shishberg/capybara/(commit log)

2026-08-23 Track the v3 pipeline; stop tracking node_modules
    v3/ has been untracked since it was started. It is now the whole PCB
    generator, so put it under version control: the BAML sources, the
    generated Kailh hotswap footprint library and the script that builds it,
    and the TypeScript harness that diffs placement against ergogen.
    node_modules/ was tracked, 3500 files of it, and churning on every npm
    install. package.json and package-lock.json are both committed, so
    `npm ci` reproduces it exactly.
    Also ignored: output_v3/ (one `make v3` away from the sources beside
    it), KiCad's per-user .kicad_prl and lock files, and v3/datasheets/,
    which is 63MB of vendor PDFs and a STEP model.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
2026-08-23 Stand the finger connectors on the pod-facing edge; fix the LED's rotation
    Both halves put their ribbon connectors on the edge facing the pod -- the
    right of the left half, the left of the right half -- so the cables leave
    toward the middle of the keyboard instead of doubling back around the
    board. Turning a connector through a right angle turns the fan-in with
    it, and three things had to follow.
    The connector's angle now decides the fan-in's planarity. Two chords
    joining two disjoint arcs of a convex region never cross exactly when
    the matching reverses the boundary order, and it is the connector's
    rotation that fixes which end contact 1 sits at. The angle that points
    the cable off the boa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
2026-08-24 v3: place ribbon connectors by where their cables go, shrink the key boards
    Every connector now points its cable at the board it feeds. The pod link
    stands on the inboard edge level with the switches and is met by a bus; the
    finger board's thumb link sits below the innermost column facing down; the
    thumb board's connector sits above its keys facing up.
    Turning a connector decides which end of it contact 1 is at, so the pinouts
    follow: rows reverse on both hands, columns only on the left. The bus turns
    its corner one row per conductor -- diagonals straight onto the lanes cross
    every lane. BUS_STANDOFF keeps the first lane clear of the connector's own
    mounting-peg ground pads.
    Finger boards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
2026-08-24 Separate the finger and thumb boards into a working flat layout
    The boards used to overlap where the thumb cluster tucks under the
    fingers, which cannot be fabricated as separate coplanar boards. Now:
    - Every key board escapes north; the fan band sits above the keys and
    the pod-link pinouts are re-derived for it (band_pinout).
    - The finger/thumb link pair sits in the inboard corridor above the
    thumb home key, both halves computing the same spot (link_spot) so
    the connectors face each other dead-on across a 3mm board gap.
    - The thumb fan runs on the back, tucked between the contact line and
    the near key's holes, surfacing through vias behind each contact.
    - Pass-throughs dive to the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
2026-08-24 v3: clear the LED variant's last DRC violations
    The chain now lands clean on all four key boards in both variants.
    * The thumb cluster gets its own hop shape and starts at the far key, so
    its head enters without crossing the cluster.
    * The finger head comes down the outside of the first column in the
    *column's* frame -- the columns are splayed, so a vertical drop walks
    across the key frame into the socket pads on one hand and the
    transition lanes on the other.
    * South of a key is one shared corridor: the LED's ground drop is now a
    stub straight off its pad instead of a hook across it, and the
    under-the-bottom crossing and the tail share the row it frees. The old
    deep crossing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
2026-08-24 v3: fix FFC cable mapping — every link was cross-wired end to end
    A same-side FFC between facing connectors joins contacts by position, and
    the facing turns one row around: pad 1 lands on pad N. Both ends of every
    ribbon assigned signal i to pad i, which no check could see — the combined
    view joins nets by name and nothing models the cable. The pod's two FFC
    connectors were also mounted with their cable openings toward the pod's
    centre, and the pod link's contact rows sat 4.5mm below the finger boards'.
    - from_end_signals: the from-end of each ribbon numbers its pads from the
    reversed signal list (pod for the pod links, finger for the thumb links)
    - pod_connector_angle flipped so the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
2026-08-24 v3: slope the fan band to the key stagger, and build LED-only
    The band above the finger keys was a flat slab held clear of the tallest
    column, wasting the whole ~25mm stagger over every other column. The exit
    line is now an ExitLine {y0, m}: finger_exit_line fits the tightest straight
    line that clears one constraint point per obstacle -- each column's top
    signal pad, each key's ground-stitch via (5.4mm higher than the pad; the
    flat design cleared these only by luck), and the LED chain's over-the-top
    column crossings, which climb to the taller neighbour's height. The whole
    band shears with the line, which preserves every planarity argument, and
    the flat clearance itself dropped from 13mm to w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
2026-08-25 v3: flatten the fan band and drop it onto the tallest column
    The sloped exit line was a mistake: it minimised slack over its constraint
    points, most of which sit on the short side columns, so it rode ~7mm high
    over the middle column -- the one place the eye (and the user) measures.
    Undo the slope entirely; the line is horizontal again and simply as low as
    the constraints allow.
    What actually lets it drop ~14mm:
    * LED column transitions no longer cross over the top of the columns. Both
    ends of a top transition attach on their east sides (west of every key,
    the key-below's socket ground hook climbs through the exit row), and the
    link threads the shared corridor and the eastern key's no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
2026-08-25 v3: stack the fan band per column so it hugs every column
    The flat exit line held all 16 band rows on one ladder fitted to the
    tallest column, so the six rows serving the inner and index columns --
    which turn off toward the connector before reaching the middle column --
    left ~8mm of empty air over the middle column's keycaps.
    Replace the shared line with per-column band groups: columns ordered
    nearest-the-connector-first, each group of rows sitting as low as that
    column's own top signal pads and ground-stitch vias allow, or one bus
    pitch above the previous group's top, whichever is farther out. Each
    column's escape channel now ends one bus gap short of its own group
    instead of on the shared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
2026-08-28 v3: emit the segmented outline, and fix what emitting it found
    The flex geometry existed and was tested but nothing wrote it out, so
    none of it had ever met KiCad. Emitting it turned up four real defects,
    each of which is now a test.
    Board gains `cuts: Vec2[][]` for interior Edge.Cuts contours, threaded
    through every construction site; `emit_panel` writes one closed polygon
    per cut, numbered from a range far clear of the outlines so a rigid
    board's file is unchanged by their existence. `flex_board.baml` turns a
    module into strips, cuts, parts and connectors, and `build_boards`
    dispatches to it on the new `flex` feature. `route.baml:enclose` never
    runs on that path -- on a segmented board th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
2026-08-28 v3: route the segmented finger boards for the matrix
    A second router. The direct-wired one in `route.baml` still builds the
    rigid boards, which are the shipping design and what every parity test
    pins; this one only ever sees a strip.
    The whole topology falls out of two facts about the Kailh footprint. Its
    drill holes shut out the middle of the strip on both layers, so the only
    lanes past a key are the two bands outside them -- and its socket pads
    own the west band on the back, so every run along a column is on the
    front. And everything the footprint owns lies north of the key centre,
    which leaves the strip below the bottom key clear across its full width:
    that is where the bus goes, and the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
2026-08-28 v3: place the pod connector from the fan the ribbon actually needs
    pod_lanes() guesses half the ribbon plus one, and the connector was placed
    from that guess. The guess holds for the twenty-way direct-wired ribbon; the
    eleven-way matrix ribbon puts every leg on the same side of the fan, so the
    channel ran two lanes past where the connector sat and both outer lanes
    crossed the FFC's mounting pegs -- four nets shorted to ground.
    Lay the fan out twice. The guess only feeds the connector's x and the split
    only depends on y, so a fan built against the guessed position already knows
    its true half-width.
    Claude-Session: https://cl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
2026-08-28 v3: drop probe.baml, a scratch dump that got swept into a commit
    Claude-Session: https://claude.ai/code/session_01ERBCadru14VoSwU2wTTzvK
2026-08-28 v3: flex routing rules, as checks
    Five rules a folded board has to obey, none of which DRC can see -- KiCad has
    no idea which parts of this outline fold. They run over the routed boards
    rather than over the functions that build them, so a future router still
    answers to them.
    The one that needed a change was the pour. `board_zones` pours over the whole
    outline, which on a segmented board means a solid plane across every ligament
    and down every neck: a stiffener where the board is meant to give, and a crack
    starter at the cut edge that starts it. Under the matrix neither switch
    terminal is ground, so the only ground on a finger board is the two links'
    contacts and mounting pegs -- and both li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
2026-08-28 v3: cut and route the thumb cluster
    The cluster is not the shape `strips_of` cuts. Its three keys sit almost
    in a plane, splayed round the thumb's arc rather than stacked along a
    cylinder, and the only place it wants to fold is the one gap wide enough
    to put a serpentine in. So it is cut the way BastardKB cuts its five-key
    cluster: rigid islands joined by one neck, {near, home} | {far}, which
    sends two lines over the seam where the other cut would send three.
    Everything is stated in the cluster's own frame -- x along the near-to-far
    run, y across it -- where the islands are rectangles and `Strip`,
    `flex_ring` and `strip_neck` apply unchanged. `Frame.flip` makes one
    description serve both ha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
2026-08-29 v3: move the pod connector off the tail, onto a shelf beside SW14
    The tail was 34mm of board hanging off the bottom of the inboard column,
    carrying both links. Below that column there is about 9mm of plan-view
    daylight before the thumb cluster's own keycaps start, so 25mm of that
    tail ran straight through the cluster it was reaching for.
    So the pod link comes off it. It stands instead on a shelf hung off the
    inboard edge beside the home key -- which is where the pod is, and the
    only stretch of that edge with a hinge row far enough away at both ends.
    The thumb link keeps the tail, pointing at the cluster below it, and the
    tail shrinks to the 11.6mm that one connector needs.
    The shelf is not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
2026-09-26 v4: track the chassis pipeline and editor
    v4 had been built up without ever being committed. Adds the v4 source,
    its make targets, the README pointer to the active design, and ignores
    for generated output, editor build artifacts and agent worktrees.
    [trackball.brd]
2026-09-26 v4: one hand-edited pod pin map, pod.json
    The pod's pins were spread across trackball.py (two maps of the same
    pins), validate.py, build_key_quotes.py, the v3 BAML header tables and a
    string-patched pinout.txt. pod.json now holds the module header, pin
    concession costs and the hand-chosen trackball and rgb groups.
    The seed stages its header and costs from pod.json and cannot take a
    fixed group's GPIO. The build reads the finished pod back into
    pod-pins.json, and renders pinout.txt and a full firmware-pinout.json
    from it. Validation and the RGB quote pod check against pod.json.
    All seven v4 boards are unchanged against a pre-refactor build. The RGB
    quote pod has the same footprints and nets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
    [pod_pins.py, seed.py]
2026-09-26 v4: docs match the key-tile decision; add design-status.md
    Record decisions and open questions in one place, mark the flex finger
    and flat thumb docs as paused reference, update LED power (module USB
    5V, ~300 mA cap), flag the Molex connector for replacement and the
    undersized chassis adapter placeholder.
2026-09-26 v4: power the LEDs from module USB 5V; swap to the JUSHUO FFC connector
    Drop the pod's separate J3 LED input and feed +5V from the module's 5V
    header pin, listed in pod.json's rgb group. Replace the Molex 200528-0240
    (MOQ 9,000) with the LCSC-stocked JUSHUO AFA07-S24FCA-00; the breakout
    grows to 36 x 33 mm. Both boards reroute DRC-clean and pass the audit.
    [draw_key_wiring_layout.py]
2026-09-26 v4: drop the 470 uF bulk capacitor from the hand breakout
    It came from the separate LED supply design; on USB power it only adds
    plug-in inrush. LED decoupling stays an open per-column question.
2026-09-26 v4: first prototype uses a perfboard pod and generic FFC adapters
    Custom PCBs have the longest turnaround and can't change once ordered,
    while the pod wiring will still change. The generated breakout and pod
    stay for a later build.
2026-09-26 v4: use 0.5 mm pitch FFC for the prototype ribbon
    Half the width of 1.0 mm cable, leaving more room to adjust the angle
    between the hands and the pod; the LED current is well within rating.
2026-09-27 v4: PROTOTYPE chassis shape options and extra thumb keys (throwaway)
    Six shapes on the same key poses (current shell, Skeletyl-style webbed
    well, column ribs, faceted block, pedestals, floating plate on legs) and
    three thumb options (3 keys, +2 outer, +2 tucked below). Open
    /prototype-shapes.html on the editor dev server.
2026-09-28 v4: PROTOTYPE Skeletyl construction, middle-ground shapes, moved extra thumbs
    Skeletyl construction rebuilt on Rosebear key poses; the old webbed well
    renamed Dactyl-Manuform. Adds soft-edged webbed well, machined tray and
    pebble facets; drops pedestals. Outer extra thumbs use finger splay;
    tucked-below extras sit under the gaps between the three thumb keys.
2026-09-28 v4: PROTOTYPE fix Skeletyl artefacts, rounded column ends, inner support, plate toggle
    Drop the smoothing that spiked thin walls, restore switch holes, one flat
    skirt per key, larger thumb window, quarter-round column ends inside an
    extended tray, solid inner wall joined to the thumbs, Cirque moved 8 mm
    out. Bottom plate checkbox; cam/caps/plate URL params for inspection.
2026-09-28 v4: PROTOTYPE skeletyl framed inner wall, column-end feet, one-piece check
    Column ends get a foot out to the tray rim so the case holds together
    without the removable base. The stats line reports how many pieces are
    left above the base; that check also found ribs plates only touching
    their ribs, now overlapped.
2026-09-28 v4: PROTOTYPE skeletyl floor ledge instead of feet, fix tray outline hull
    The feet reached toward the rim and were trimmed into fins. A 2 mm floor
    ledge now runs from the rim in under the column walls. The tray outline
    built its convex hulls with new CrossSection(points).hull(), whose fill
    rule dropped points, so back caps hung past the rim; it now uses a plain
    2D hull. The stats line also lists loose pieces and parts outside the rim
    by location, and ?only= / ?nocut=1 isolate Skeletyl parts for debugging.
2026-09-28 v4: PROTOTYPE eight-view review sheet script for chassis shapes
2026-09-28 v4: PROTOTYPE skeletyl bridged columns and angled end walls with a hugging tray
2026-09-28 v4: PROTOTYPE highlight skeletyl bridges in orange (?hl= tags, ?hlinfo=1 sizes)
2026-09-28 v4: PROTOTYPE skeletyl bridged variants join column end walls in their lower half
    Replaces the bars between the key-frame flanges. No rim or lip; the base
    plate is flush with the walls.
2026-09-28 v4: prototype three continuous column-end shapes (fitted, swept, carved); highlight off by default
2026-09-28 v4: prototype swept thumb-row front (skel-swept-thumbs)
2026-09-28 v4: prototype thumb layout with wells, wider spacing and room from the finger columns; keycap clearance check
2026-09-28 v4: promote the swept Skeletyl chassis to the editor, edited through key layout parameters
    Finger columns take three key heights, stagger, X offset, sideways tilt and
    splay; thumb clusters take centre, angle, tilts, arc radius, key spacing and
    well. Handles drag key heights, stagger, cluster centres and cluster angle.
    The chassis is generated from the key poses and checked for seats, openings,
    tile and keycap clearance, loose pieces and keycap gaps. The Cirque pod
    replaces the trackball placeholder.
2026-09-28 v4: side walls rise from the outside columns' plate edges and close the swept ends' corners
2026-09-28 v4: per-key walls that follow the plates past the tile pockets, U slots, base ribs and a connected-footprint check
    Walls on the inner and pinky columns and the thumb rows start at the plate edge
    just outside the tile pocket, follow the plate's tilt to the pocket's depth,
    then drop to the base, one segment per key with U slots between. Caps close the
    swept ends' quarter rounds. Ribs join the thumb rows and fingers along the base,
    and the checker requires one connected footprint without the bottom plate. The
    seat footprint shrinks to 15.8 mm and the cut above each plate only clears the
    housing rim and keycap travel. The bottom plate is hidden by default.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
2026-09-29 v4: plates sized from the switch seat, and nothing built into a tile pocket
    Plates are now 0.9 mm past the 15.8 mm seat (17.6 mm square) instead of keycap
    sized, so they no longer stick out past the swept ends; skirts, which the tile
    pockets would remove, are gone. Swept ends start past the end keys' tile
    pockets. Wall segments, joints and caps are built as separate tilted and
    vertical hulls so no hull reaches into a pocket on a rolled key. The thumb
    support and web are removed, the pod bracket is fixed to the plate corners,
    and the default thumb clusters move 3 mm toward the user to clear the fingers'
    front end. The checker fails when any part reaches into a tile pocket.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
2026-09-29 v4: restore the U slots between wall segments, which the smaller plates had disabled
2026-09-29 v4: descriptive names and typed wall strips, caps and curves in the chassis code (no geometry change)
2026-09-29 v4: named construction sizes and check limits, and a geometry fingerprint for refactors (no geometry change)
2026-09-29 v4: wall check for gaps and blind slots, and close the gaps and groove where the pinky wall meets its caps
    The checker looks straight through each wall segment and each U slot, taking in
    only the wall's own thickness. A hole that is not a slot is a gap; a slot with no
    hole is blind. Both are listed and highlighted. The chassis reports the windows.
    The cap's drop hull now shares the carried tilted part's bottom edge, which
    closes the wedge-shaped slits beside both pinky caps. The cap's round hull takes
    in the drop's outer top corner, which removes a shallow groove on rolled keys.
2026-09-29 v4: swept ends follow each column's end, and a check for chassis built where a keycap goes
    The swept end's curve was a quadratic fit through all the column ends, pushed
    out until the round started past every tile pocket in plan. That left 5-10 mm
    of flat plate at most column ends, and the front round reached far enough
    forward that the 1.5u thumb key's room cut 74 mm³ out of the inner column.
    Now the curve runs parallel to each column's plate edge, as close in as the
    tile pocket and switch body allow (they must stay inside the round's hollow,
    not just short of it in plan), and never inside the switch seat. A smooth
    maximum joins the columns' lines. Flats are now 0.4-2.3 mm.
    New check: the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
2026-09-29 v4: plates cover the tile, swept ends stay within the end plates, both thumb row ends tie to the fingers
2026-09-29 v4: walls flush with the plate edges, with a cutout under each key and posts between keys
2026-09-29 v4: experimental hex strut pattern for tall walls (chassis.wall_pattern)
2026-09-29 v4: cut the hex pattern off at the base strip on short walls
    Keys whose upright would be shorter than the wall width lose the strut
    below them, so the pinky column and extra thumb pair get the pattern too.
    End half hexagons are cut only where a cap closes the run's end. The wall
    check closes zero-width slits left by projection.
2026-09-29 v4: the wall check accepts holes a neighbouring key's opening passes through
2026-09-29 v4: default thumb clusters closer to the fingers and each other
2026-09-29 v4: fill the switch seats before trimming them
    Trimming first put the trimmed faces exactly on the seat plates' faces,
    and Manifold's union then dropped 18 mm³ elsewhere: a wedge cut from the
    index home plate's edge. Test the plate side edges against the chassis.
2026-09-29 v4: PROTOTYPE tile rests: webs between keys with feet under the tiles' edges
2026-09-30 v4: PROTOTYPE tile rests bridge the finger columns under the tiles' side edges
    In each finger row a rest joins neighbouring columns' plates; the outer
    columns get a bar across the wall cutout, hung from the plate either side.
    The thumb rows keep the rests along the row. The rests' cut starts at the
    plate's underside so they overlap the plate instead of sharing its edge face.
2026-09-30 v4: PROTOTYPE finger tile rests: short feet under the back of each tile's side edges
    A tile goes up 4.3 mm in front of its place and slides back onto the feet,
    which sit under the socket. The bridges between columns stay 12 mm long.
    Only the index, middle and ring columns' top and home tiles fit this way:
    bottom-row tiles hit the front swept end and outer-column tiles the wall
    posts.
2026-09-30 v4: PROTOTYPE finger tile rests every tile can be fitted past
    Feet and webs line up along the back of each tile's side edges, under the
    socket, from 2.3 mm behind the centre: a tile goes up 7.5 mm in front of its
    place and slides back. The bottom row is turned 180 degrees so its tiles
    slide forward, clear of the front swept end. The outer columns' tiles come in
    sideways through their wall cutouts, with feet at the cutouts' ends; the
    inner bottom tile, blocked by the trackpad pod, slides through a slot cut in
    the post. The wall check closes its view's ends so the slot's merged opening
    is still a hole, and a new test sweeps every finger tile's way in.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
2026-09-30 v4: walls stand outside the plate edges; catch small loose pieces
    The inner bottom post slot cut one of its tile's feet loose, and the
    loose-piece check missed it because it ignored pieces under 50 mm³. It
    now ignores only slivers under 0.5 mm³.
    Walls now stand wall_mm outside the plate edges, so the tile pockets stay
    inside them rather than running out through the wall. Every finger tile
    now slides onto its feet, including the outer columns', so tile_side_entry
    and the post slot are gone; the outer feet hang from the wall. Swept ends
    run on to the wall's face, the hex openings stop at the plate's
    underside, and the pod bracket reaches the wall's face.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
2026-10-01 v4: model the hand wiring, adapter mount, ribbon and trackpad housing in the editor
    Provisional, from photos and spec sheets: tile pads, a 4 x 5 matrix per
    hand (thumbs as row RX on ribbon pin 12), wires routed pad to pad and to a
    generic 24-way FFC adapter on the bottom plate, with a ribbon landing and
    notch in the inner wall. Thumb wires reach the fingers through a round port.
    The trackpad housing is a separate, symmetric print on a dovetail mount.
    New checks: wires, solder access, housing fit and slide. Old projects are
    migrated to the new config sections.
2026-10-01 v4: document the wiring model, the 4 x 5 matrix and the new chassis parts
2026-10-01 v4: route wires without crossings, close under the tiles, in the build worker; adapter toggle
    Legs hop 0.6 mm under the tile and run strips from 2.7 mm. Port wires
    take their own places on a 1.02 mm hex grid in the 5 mm port. A
    negotiated router with blocker pushing, group repair and a wide second
    pass removes all crossings, and the fit report now checks wire against
    wire. Routing moves into the build worker, so wires update on rebuild.
    A new "Adapter and ribbons" toggle hides the adapter.
2026-10-01 v4: keep the bottom row facing the same way as the others
    The bottom row was turned 180 degrees so its tiles could slide forward onto
    their rests. Instead it keeps its orientation, and its tiles slide forward
    onto feet under the front of their side edges; the router keeps wires out of
    that room. Finer shifts along a tile's edge and more blockers moved aside
    keep every fingerprint variant routing without crossings.
2026-10-01 v4: socket posts on the bottom plate hold the bottom row's socket end
    A bottom-row tile slides forward onto feet under the front of its side
    edges, so nothing held its socket end, and pressing a switch in would lever
    it down. A 3 mm post on the bottom plate now stands under the middle of each
    bottom-row socket, 0.3 mm below it. The router keeps wires off the posts as
    round obstacles, and its restarts shuffle the order of the wires that already
    met nothing, so every fingerprint variant still routes without crossings.
2026-10-01 Revert "v4: socket posts on the bottom plate hold the bottom row's socket end"
    This reverts commit 96f0486c5f78318bc8677b8d491f79ba2b8adf66.
2026-10-01 v4: hold a bottom-row tile up by hand while its switch is pressed in
2026-10-01 v4: lids over the finger tiles' feet hold each tile edge in a slot
    The bottom row's feet are under the front of the tile, so pressing a switch
    in levered the socket end down about them. A lid from the plate to 0.2 mm
    above each foot stops the tile tipping. The seat test now skips edge rays
    that start inside both bodies, where the plate runs on into a bridge.
2026-10-01 v4: bottom-row lids beyond the feet, not over them, so no support fills a slot
    The lids over the feet left a 1.8 mm slot that a print on its base would fill
    with support. The bottom row's lids now run from 6.5 mm in front of the centre
    to the tile's front end, and its feet stop 1.5 mm short of them, so nothing is
    under a lid down to the bed. The other rows' feet are under the socket and
    need no lids.
2026-10-10 v4: PROTOTYPE Commodore 64 breadbin chassis shape (c64 variant)
    Rectangular wedge with its deck tilted to a plane fitted through the key
    plates, bullnose front, rounded underside, rear chamfer with grill grooves,
    parting line, and the keys in a stepped well with a moat; the trackpad gets
    its own well like the C64's function keys. Beige shell, brown caps.
2026-10-10 v4: PROTOTYPE C64 breadbins, one per cluster (c64-clusters variant)
    The C64 builder now takes a list of bins, each built in its own plan
    rotation with its own deck plane, margins and bullnose. c64-clusters gives
    the fingers, the thumb row and the trackpad a tight bin each: 181 cm² in
    plan against 143 for skel-swept-thumbs and 311 for the single breadbin.
2026-10-10 v4: PROTOTYPE C64 bins drop the trackpad; moat is a thin trough following the case outline
2026-10-10 v4: PROTOTYPE C64 bins: thumb grill on the outer end, rounded top end edges, bottom section below the parting line
2026-10-10 v4: PROTOTYPE C64 bins follow the C64's side profile and are hollow
    Spline bullnose from a vertical front face into a deck that rises to the
    back at 5 degrees at least, a raked back face with a rounded top corner and
    the grill in front of it, ends rounded all round by lofting shrinking
    slices. 2 mm walls; the key wells keep their wall and floor, and each key
    stands on a hollow pedestal open to the case below. Trackpad support dropped.
2026-10-10 v4: PROTOTYPE C64 bins use the profile fitted to the C64 photo
    Fillets keep the photo's sizes and shapes, scaled so its gutter sits on
    the parting line; the grill top stays flat and the back stays two faces
    (7.2 degrees raked, then vertical) meeting at the gutter. The deck angle
    and the bin's depth and height come from the keys.
2026-10-10 v4: PROTOTYPE C64 bins keep the well floor above the parting line
    The bottom section is now a plain tray; where the deck is low the well
    floor sits just above the parting line instead of dropping into it.
    ?top=0 in the prototype hides the top case to show the bottom section.
2026-10-10 v4: PROTOTYPE C64 curved-deck variant; thumb bins lose their grill
    c64-curved fits a quadratic surface through each cluster's key plates and
    moves only the deck onto it: in front of the well it eases back onto the
    fitted bullnose, behind it ramps to a raised flat deck so the grill top
    stays flat. The thumb bins in both cluster variants have no grill.
2026-10-10 v4: PROTOTYPE C64 curved deck lofted from continuous sections, with four back treatments
    Each section across a curved bin is one outline (bullnose, key surface,
    ramp, flat top, back), lofted into a mesh. Variants: level top, top
    following the dish, deeper back, mid-height top. Also: thumb bin trimmed
    at the finger bin, finer end rounding, split at the parting groove's
    bottom, ?look= camera target.
2026-10-10 v4: PROTOTYPE C64 curved deck: drop the deeper-back variant, add a tilted straight top
2026-10-11 v4: PROTOTYPE shapes page: fresh manifold instance per build, coarser curved-deck loft
    Manifold objects were never freed, so a few curved builds exhausted wasm
    memory and every later switch failed (decompose: index out of bounds).
    The curved loft now uses fewer stations and section points (4.2 s to 1.8 s).
2026-10-11 v4: PROTOTYPE C64 curved deck holds level past the outer rows' key centres, lowering the front lip and back top
2026-10-11 v4: PROTOTYPE C64 curved deck: front lip and back top at the same height
2026-10-11 v4: PROTOTYPE shapes page: description and stats as HTML comments, not over the model
2026-10-11 v4: PROTOTYPE C64 curved deck holds level beyond the end columns' key centres, flattening the index end
2026-10-11 v4: PROTOTYPE C64 bins: port panel on the index end where the ribbon leaves
2026-10-11 v4: PROTOTYPE C64 bins: halve the end rounding to 2 mm; expose plan outlines as __plan
2026-10-11 v4: PROTOTYPE C64 joined variant: thumb row carried in the finger bin's deck sections, hard-cornered joint
    The finger bin's sections run forward over the thumb row to the thumb bin's
    front edge; the thumb surface meets the finger surface along a straight run
    between the wells' hulls, with a hard angle at each end. The loft now matches
    marked corners between sections so those angles don't twist.
2026-10-11 v4: PROTOTYPE C64 joined: thumb deck rises to the finger well rim at the pinky end; clean parting groove (cut without coincident faces)
2026-10-11 v4: PROTOTYPE C64 curved bins: flat top long enough for three grill grooves
2026-10-11 v4: PROTOTYPE C64 joined: one lofted solid, thumb sections turning to meet the finger bin's, index end rounded
2026-10-11 v4: PROTOTYPE shapes viewer: paint marks on the model (M), saved with camera, note and screenshot to prototype-marks/ via a dev-server endpoint
2026-10-11 v4: PROTOTYPE C64 joined: index end rounded with one outline shrunk unevenly (no merged thumb outline), pinky end rounds fully; smooth deck clamps (no crease); trench and grill cut without coincident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
    Also saves the first five painted marks, and ?marks=0 hides saved marks.
2026-10-11 v4: PROTOTYPE shapes viewer: Delete all saved marks button
2026-10-11 v4: PROTOTYPE C64 joined: optional C64 badge on a bin's grill (pill recess interrupting the grooves, five raised staggered stripes); new c64-joined-badge variant
2026-10-11 v4: PROTOTYPE C64 badge: stripes square-ended and lined up, not slanted
2026-10-11 v4: PROTOTYPE marks: inside-corner bottom edge
2026-10-11 v4: PROTOTYPE C64 badge: stripes run out to the centres of the pill's rounded ends
2026-10-11 v4: PROTOTYPE C64 joined: rounded wall between the thumb deck and the finger top instead of the ramp; trench stops either side of it; index end rounds in fully and stops against the thumb part (no sp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
2026-10-11 v4: PROTOTYPE C64 joined: wall between the decks 2.4 mm further forward; the thumb trench runs into it and stops flush
2026-10-11 v4: PROTOTYPE shapes: keep only the C64 joined chassis with the badge; drop the other 22 variants and the code only they used (Skeletyl, carved, machined, faceted, trackpad well, flat deck, other bac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
    The removed shapes stay in git history (b1cb2d8 has them all). The remaining build is pixel-identical to before.
2026-10-11 v4: PROTOTYPE C64 joined: finger trench runs on over the wall's rounded top edge and falls off it; the wall's round is in the mesh (loft runs sized by their longest section, round ends marked, 1 mm s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
2026-10-11 v4: PROTOTYPE C64 joined: the finger well's front edge carries straight on past its ends, so the wall's top and strip don't step forward where the well ends (with the mark)
2026-10-11 v4: C64 case is the editor's chassis: plate sheets per well, rooms and skirts, tiles glued to pads; no trackpad, ribbon out the port panel
    - shell.ts (from the prototype's variants.ts) builds the C64 case; chassis.ts puts
    the plates in its wells as one sheet per well, with 2 mm reaches and joins,
    rooms cut under the plates and skirts closing the deck's wall
    - tile rests, bridges, feet, walls and the trackpad housing are gone; tiles are
    glued to four L pads under each plate
    - wiring: plates are obstacles; joins step back under the higher tile, turn a
    corner or run under both ends
    - extra thumbs moved 1.5 mm out and 1.5 mm forward to clear the finger well
    - buildSolid frees every Manif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
2026-10-11 v4: rebuild in about 3 s instead of 11.5 s, with the same wiring and checks
    - Route the wires once per build, not once for the skirts and again for the checks.
    - Wire router (2.8 s to 1.1 s, same routes): legs and the joins between them are
    made once and shared; segment tests use a plan grid of the obstacles and skip
    any obstacle whose gap on one axis is past the wire's reach; caches key on
    shared points, not strings.
    - Checks test against each key's piece of the chassis (cut from its column's,
    cut from the whole once), not the whole chassis, for every probe and envelope.
    - Keycap rooms and switch holes are cut in one boolean, not two per key.
    - Skirt notches only from the wire segme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
2026-10-11 v4: route the wires in their own worker while the shell is lofted; climbs found once per leg (rebuild about 2.2 s in the browser)
2026-10-11 v4: the port insert holds the ribbon: a neck through the wall and the tie-down landing inside, placed from the panel instead of the adapter (which stands 4 mm further in)
2026-10-11 v4: loft the wall between the decks every millimetre where it fades out, so it no longer twists into a fan of slivers
2026-10-11 v4: PROTOTYPE ?plates=narrow: finger plates flat only 0.8 mm past the switch seat, falling at 60 degrees (?slope=) by up to 2 mm towards the well's wall, joins between in-line neighbours cut the same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
2026-10-11 v4: PROTOTYPE ?plates=narrow: lower the finger sheet's top 2 mm along the well's wall outside each key's keep (flat to 0.8 mm past the seat, then 60 degrees down) and its neighbours' bridged keeps, r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
2026-10-11 v4: PROTOTYPE ?plates=narrow: build each finger plate narrow instead of cutting full plates down: full thickness only to 0.8 mm past the seat on sides facing the wall, then a 60 degree slope down 2 m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
2026-10-11 v4: PROTOTYPE ?recess=mm: the case top this far above the plates' tops (default 3), the wells' walls reaching down as much further; key wells' corners square like the C64's
2026-10-11 v4: PROTOTYPE ?plates=facets: the finger plates as one 3 mm floor, each key's plate-top plane carried on until it meets its neighbours', out to the well's wall, flat to 0.8 mm past every seat; tiles 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
2026-10-11 v4: PROTOTYPE ?plates=facets: the room under the keys stops at the floor's underside, so it no longer cuts the well's wall away above the floor (the slot whose kinked edge looked jagged); the flat-ar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
2026-10-11 v4: editor: a remembered 'show edges' no longer crashes the page on load, before the first chassis has arrived
2026-10-11 v4: editor: the edges toggle is labelled Show wireframe
2026-10-11 v4: PROTOTYPE ?plates=facets: where a neighbour's plane stands above a key's flat area (the ring and pinky columns), a sloping step between the two flat areas' edges replaces the notches
2026-10-11 v4: PROTOTYPE ?plates=facets: the floor is a flat square 0.8 mm past each seat, straight strips between neighbours and a patch where four keys meet, carried on level past the outer keys to the wall, 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
2026-10-13 v4: hand model: fingertip rest positions, thumb landing points, segment lengths and resting pose of the left hand, measured from grid-paper photos, with the scripts that rebuild it
2026-10-13 v4: hand model: an assumed thumb base joint (CMC), placed by typical anatomy and fitted so the thumb reaches all five prints, since the photos show the thumb knuckles at rest only
2026-10-13 v4: PROTOTYPE ?hand=A|B|C: the measured hand drawn in the editor, and three ways it could drive the layout: rows as joint angles (A), rows as reach in mm with the hand solving the angles (B), or the 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
2026-10-13 v4: PROTOTYPE ?hand: one screen in place of A/B/C: tent, roll and wrist angles for the hand, a curl per finger, row reach in mm (rows stay level and the hand slides), the thumb posed from the assumed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
2026-10-13 v4: PROTOTYPE ?hand: a slider shares each row's reach between the fingers (free to rise or drop) and the hand sliding; the thumb row sweeps from the home key square to the way the thumb presses, with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
2026-10-13 v4: PROTOTYPE ?hand: the thumb row as the thumb reaching from the CMC with the MCP and IP held, so the keys sit on a sphere round the CMC, each facing against the thumb's curl; sliders for the row's 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
2026-10-13 v4: PROTOTYPE ?hand: fingers reach rows by curling or straightening (PIP, knuckle held) and press by pivoting at the knuckle, so each finger key faces against that pivot
2026-10-13 v4: PROTOTYPE ?hand: the DIP follows the PIP but straightens no further than straight (or its resting angle where pressing bent it back), so the top row's fingertips no longer hyperextend
2026-10-13 v4: PROTOTYPE ?hand: a Reset hand button puts the hand sliders back to their defaults
2026-10-13 v4: PROTOTYPE ?hand: anchor the hand on the middle home cap top through the key's own tilt, so reloading no longer walks the layout away
2026-10-13 v4: PROTOTYPE ?hand: fingers press with the MCP flexing while the PIP and DIP give (Jindrich et al. 2004's mean pattern, scaled by a slider); the readout gives the middle finger's key slope per row
2026-10-13 v4: PROTOTYPE ?hand: name the MCP in the press slider's label
2026-10-13 v4: PROTOTYPE ?hand: work backwards from the keys: each column's keys lie on a line tilted from the plate and face square off it, the MCP and PIP are solved to reach each key, and the readout gives t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
2026-10-13 v4: PROTOTYPE ?hand: the keyboard is local to each key: reaching is along it and pressing square to it at that point; set either the reach mix (the fingertip's path is the keyboard) or the press mix 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
2026-10-13 v4: PROTOTYPE ?hand: the thumb set by joint angles (CMC sweep, abduction, twist; MCP+IP curl), pressing like a finger by curling (with a slider to blend in CMC abduction); the CMC reaches between key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
2026-10-13 v4: PROTOTYPE ?hand: readout of the height from the base to the highest keycap corner, overall and for the finger keys alone, against the 66 mm keyboard tray; widen the thumb sweep slider to -80..30
2026-10-13 v4: PROTOTYPE ?hand: the height readout also gives the height without the far thumb key
2026-10-13 v4: PROTOTYPE ?hand: a 1.5u + 2x1u thumb cluster: the 1.5u at the thumb's home pose lying along the row, the 1u row a finger's step away (MCP and IP, by a reach mix or square to the press, within gue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
2026-10-13 v4: PROTOTYPE ?hand: the readout gives the index-to-pinky cap-top slope per row, against the Dactyl Manuform's 12.8 degrees
2026-10-13 v4: PROTOTYPE ?hand: the 1.5u + 2x1u keys face square to the row and the step between rows, so the 1u row no longer runs into the 1.5u; the readout gives how far the press is off square; the step def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
2026-10-13 v4: PROTOTYPE ?hand: tent defaults to 20 degrees (30 looked too steep)
2026-10-14 v4: PROTOTYPE ?hand: the thumb's home key defaults to the thumb at rest, pressed from the CMC like a finger from its knuckle (CMC abduction 3 degrees per MCP degree, the IP still), so the keys face 3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
2026-10-14 v4: PROTOTYPE ?hand: grey out and disable sliders that do nothing with the other settings as they are (the reach or press mix not in use, the 1u row's sliders without the 1.5u + 2x1u cluster)
2026-10-14 v4: PROTOTYPE ?hand: fingertips are a ball fixed to the last segment, resting on the paper at the measured print, and touch each key at the ball's lowest point along the press, so curled fingers pres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
2026-10-14 v4: PROTOTYPE ?hand: the thumb defaults (and Reset hand) to the closest fit to the Dactyl Manuform's thumb keys relative to the middle home key: sweep -23, abduction 14, twist 17, curl 14, IP -3, CMC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
2026-10-14 v4: PROTOTYPE ?hand: every hand default (and Reset hand) is the closest least-squares fit to the Dactyl Manuform's 18 keys relative to the middle home key: tent 15, roll 4, wrist 12, bend -2, curls 1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
2026-10-14 v4: PROTOTYPE ?hand: each finger column runs the way the fingertip travels from the bottom key to the top, seen from above (knuckle to fingertip pointed steeply down, so 4 degrees of roll turned the 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
2026-10-14 v4: PROTOTYPE ?hand: refit every hand default to the Dactyl Manuform with the inner column's wrist share free: it settles at 0.8 (1 fits as well), inner 10; wrist 11, curls 16/17/14/12, bottom 16, re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
2026-10-14 v4: PROTOTYPE ?hand: the inner column is set by its closest key's gap from the index column (18-30 mm) and its angle from it (0 = parallel); the hand's turn at the wrist and the index's at its knuckl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
2026-10-14 v4: PROTOTYPE ?hand: the inner column is reached by the arm carrying the hand sideways (square to the index column), not a turn at a guessed wrist pivot, plus the index turned at its knuckle (0 = par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
2026-10-14 v4: PROTOTYPE ?hand: basic and advanced settings; presets for the Dactyl fit and a natural layout; a rotation handle for the hand (on the board) or the thumb (at its CMC); the thumb row can curl the 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
    Basic: Start from Dactyl fit / Natural, the rotation handle (hand: roll,
    wrist, bend; thumb: sweep, abduction, twist), finger curl (all four
    together), key spacing (rows, inner column and thumb gaps together), thumb
    curl and the cluster. Everything else is under Advanced; the thumb's CMC
    press blend is hidden (fixed at 0: the Dactyl fit settles there).
    The thumb row: MCP and IP degrees per key (+ curls toward the near key,
    straightens t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
2026-10-14 v4: PROTOTYPE ?hand: the hand settings persist in the browser (a reload kept the keys but put the panel back on the Dactyl fit); Copy / Paste settings buttons share a layout as JSON
2026-10-14 v4: PROTOTYPE ?hand: declutter the sidebar: the readout is just Valid (with the height) or a Not valid list; shorter slider labels, headings and tooltips; drop UI how-to notes and the clearance discl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
2026-10-14 v4: PROTOTYPE ?hand: the Not valid list also says when the 1u thumb row or the inner column is out of reach (only the old readout did)
2026-10-14 v4: PROTOTYPE measured keycaps: 18.5 mm square at the base tapering to 14 mm at the top, 11 mm high, 6 mm over the plate at rest, 3.5 mm travel (switch.keycap_top_mm; the editor and the keycap checks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
    Cherry-picked from 868e9e1 (worktree-breadbin-box). The 1.5u thumb home cap is assumed 28 x 18.5 x 11. The default-chassis and keycap-collision tests keep the keycap sizes the chassis was laid out for.
2026-10-14 v4: PROTOTYPE ?hand: the checks use the tapered keycaps (in slices; the hand against the taper; the height from the top face); finger keys turn with their column as the checks have them, not the edit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
2026-10-14 v4: PROTOTYPE ?hand: test frame to print for a feel test: switch holes on pillars under each key, joined to their neighbours and along the floor, printed this way up with no supports (outside faces v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
2026-10-14 v4: PROTOTYPE ?hand: the test frame is a wireframe to print with supports (about half the filament): a plate ring with a 3 mm lip per key, webs between neighbours, posts from the matrix's corner and 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
2026-10-14 v4: PROTOTYPE ?hand: the thumb can press by swinging at the CMC (a blend with curling, which way the CMC moves it) as well as by curling, which alone stands the keys nearly on edge and runs the row a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
2026-10-14 v4: PROTOTYPE ?hand: the Dactyl fit preset is now Natural with the fingers curled 14 degrees and the thumb pressing by swinging at the CMC toward the fingers (keys 30-40 degrees flatter, within 32-36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
2026-10-14 v4: PROTOTYPE ?hand: stricter hand check (the fingers pressed and on the way between rows, the index on the inner column too, and 5 mm kept between the fingers and the thumb keys and the thumb and th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
2026-10-15 v4: editor sidebar: drop the help text that explains the UI (how the handles drag, "click a handle", the wiring section's provisional note, the hand section's tagline, the obvious copy/paste tooltips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
2026-10-15 v4: PROTOTYPE ?hand: the hand check is the rule "no part of the hand goes into any part of the keyboard reaching for any key, except into that key": each key in turn, the reaching digit on its way th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
2026-10-15 v4: PROTOTYPE ?hand: the reach mix goes down to -0.4 (the MCP curling as the PIP straightens, the Dactyl's way of reaching rows) in 0.01 steps up to 0.4, then 0.1 to 3; toward -0.5 the two cancel, th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
2026-10-15 v4: PROTOTYPE ?hand: Dactyl fit refitted with the wider reach mix: finger curl 15, reach mix 0.29 (was 14, 0.4), the valid layout whose finger keys come closest to the Dactyl's (cap tops per 2 mm, fa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
2026-10-15 v4: PROTOTYPE ?hand: the test frame doesn't rock: pressing any keycap corner pushes along the switch, and where that line meets the floor now lands within the rails (1 mm in at least). Where one didn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
2026-10-15 v4: PROTOTYPE ?hand: the test frame is a space frame of tetrahedra: the keys joined by webs are one piece (the finger matrix, the thumb cluster), each held at its outer corners (those round it from a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
2026-10-15 v4: PROTOTYPE ?hand: the test frame stands each plate of webbed keys (the finger matrix, the thumb cluster) on legs at its outer corners only: those whose key has no neighbour across either of the co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
2026-10-15 v4: PROTOTYPE ?hand: the test frame's bars are square: each strut a square bar along its length, one side level (they were hulls of two cubes, chamfered along the diagonals, which slicers read as rou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
2026-10-15 v4: PROTOTYPE ?hand: the "Test frame" checkbox is kept in localStorage (rosebear-hand-frame-on), so the frame stays shown after a reload. Test: npm run test:hand reloads and finds it still checked an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
2026-10-16 v4: PROTOTYPE ?hand: the test frame's webs join the keys' facing walls (the ring's side, a wall thick, plate top to lip bottom), not their bare edges. Where one key sits well above its neighbour (the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
2026-10-16 v4: PROTOTYPE ?hand: the thumb's turn about its metacarpal is derived, not set: it comes with the CMC's swing (Crisco et al. 2015, the first CMC's envelope of motion: a swing of θ turns the thumb θ·s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
    The Dactyl fit's thumb was held apart by its hand-set 6.6° turn: derived, pressing one thumb key put the thumb 6-7 mm in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
2026-10-16 v4: PROTOTYPE ?hand: "Show the thumb pressing it" animates the thumb onto the key it's shown on, over and over: its last 15 mm onto the key and back, the joints moving as the press settings have them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
    Co-Author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
2026-10-16 v4: PROTOTYPE ?hand: two press buttons under "Show the thumb pressing it", to switch between the two ways the thumb might press: "Swing at the base" (the thumb stiff, swinging at the CMC out from the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
2026-10-16 v4: hand: the thumb's end, 25.9 mm past the IP (left-hand.json thumb.segment_mm.ip_end): where the pencil outline round the flat thumb's tip in pose A reaches furthest along the thumb (MCP to IP), on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
2026-10-16 v4: PROTOTYPE ?hand: each thumb key lies along the thumb's last bone in a plane through the CMC, touching the round last section halfway along it on the outer edge (away from the index), and the thum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
2026-10-16 v4: PROTOTYPE ?hand: the thumb's last section is wider than deep: a flat pad 8 mm below the bone with round edges, 22 mm across (an estimate, not measured), drawn and checked as two of the old 8 mm c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
2026-10-16 v4: PROTOTYPE ?hand: wrist height (Basic, mm: the thumb's CMC above the middle home key's top, square to it) replaces the reach mix: it's what you control, and the reach mix follows (mixFor: the heig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
2026-10-16 v4: PROTOTYPE ?hand: reaching the inner column, the other digits stay on their home keys (checked only at home): the arm carries the index alone. Dactyl fit refitted at a reach seen on the Dactyl: th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
2026-10-16 v4: PROTOTYPE ?hand: the thumb keys go where the thumb sits in the photos. Its pose at each key is the photos' (the assumed CMC's poses putting the pad on the prints at rest, swept in, out and back, 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
2026-10-16 v4: PROTOTYPE ?hand: WIP, the presets aren't valid: the thumb's photographed poses fixed, and two errors in the last change. The assumed CMC's poses had the thumb 8–9 mm into the paper: the fit put e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
2026-10-16 v4: PROTOTYPE ?hand: how far the thumb lies on its outer edge on the keys is a setting (roll, degrees: 0 the pad flat, 90 the nail upright), and both presets use 60°, as felt on the Dactyl (the nail 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
2026-10-16 v4: PROTOTYPE ?hand: the 1.5u + 2×1u cluster works again. Its 1u row went in under the hand by curling the thumb toward its pose under the hand (print 5); since the roll became a setting, each pose i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
2026-10-16 v4: PROTOTYPE ?hand: WIP, the presets aren't valid: each thumb key is square to the sweep round the arc (level along it, its edges along it), replacing the plane through the CMC, which tipped the key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
2026-10-16 v4: PROTOTYPE ?hand: WIP, the Dactyl fit and 1.5u + 2×1u aren't valid: the thumb keys face straight up (as the paper did in the photos), square to the sweep both ways, and the thumb touches them with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
2026-10-16 v4: PROTOTYPE ?hand: the thumb no longer presses with its nail. The CMC fit (thumb_cmc.py) had put the knuckle dots on the side of the thumb away from the camera (95° and 105° off its line of sight),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
2026-10-16 v4: PROTOTYPE ?hand: the thumb's press and reach can be pointed. Two settings: the reach (the sweep from key to key) tilted out of level, the far key up, the keys climbing round the arc as on a circl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
2026-10-16 v4: PROTOTYPE ?hand: the thumb's reach and press are mixes of its three movements (radial abduction, palmar abduction, the curl), and the keys face whichever way they take it, replacing the tilts in 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
2026-10-16 v4: PROTOTYPE ?hand: the thumb keys move smoothly with the thumb settings. Found by sweeping each thumb setting in fine steps on both presets: (1) the press was made square to the reach with radial a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
2026-10-16 v4: PROTOTYPE ?hand: one state, in the project. Everything the panel sets (the layout's settings, the row and key the hand is shown on, pressing, the handle, the open sections, the frame and case che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
2026-10-16 v4: the keycap room check measures where the keycap goes. The room that carves the chassis is a box the cap's base wide, well above it; the check counted any chassis it removed, so with the measured 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
2026-10-16 v4: PROTOTYPE ?hand: a third preset, Yours: the layout set by hand in the editor from the Dactyl fit (rosebear-chassis-project(5).json, 16 Oct): the home key 115° round the arc, the reach 0.85° of pa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
2026-10-16 v4: PROTOTYPE ?hand: the test frame has a strut under each gap along its plates' outside edges, so the outer wall doesn't flex: a 2.4 mm post straight down from halfway down the web's outside wall (o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
2026-10-16 v4: PROTOTYPE ?hand: the thumb no longer goes through its key. Where it touches a key allowed for the key tilting across the bone only: the touching point was the print with the pad's radius taken sq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
2026-10-16 v4: PROTOTYPE ?hand: the test frame's outer walls are trusses, a web too thin to print is left out, and every preset is checked with the frame. Truss (replacing the vertical gap struts): under each o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
2026-10-16 v4: editor cleanup plan, from audits of the editor and the ?hand prototype
2026-10-16 v4: editor cleanup T0: the fingerprint covers trim, wiring, hardware placements, every check value, and the ?hand presets and frame; the margin variant binds, and splay, override and clearance varian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
2026-10-16 v4: editor cleanup T1: UI bug fixes. The Bottom section checkbox holds after a build; the selection clears when its cluster is gone instead of throwing mid-Apply/Undo; column fields find their column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
2026-10-16 v4: editor cleanup T2: ?hand bug fixes. One angle round the thumb arc, wrapped past 180° (a home key at 185° read -175° with a 312 mm miss); the press animation stops when the thumb is at rest; saved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
2026-10-16 v4: editor cleanup T3: builds free what they make, and a failed router no longer stalls them. freeAfter missed objects made with new (the lofted shell meshes and about 400 cross sections a build), so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
2026-10-16 v4: editor cleanup T4: one source for repeated calculations, and the dead config gone. geometry.ts gains isThumb, capClearance, tileUnderside and keyGroups, plates.ts tilePocketHalf, planCentre and a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
2026-10-16 v4: editor cleanup T5: one keycap envelope. geometry.ts keycapEnvelope gives the measured cap's taper, rest height, pressed floor and clearance as numbers; chassis keycapSolid builds it, for the keyc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
    Behaviour change: the swept keycap check's taper now starts at rest and is cap + clearance tall, as the room the chassis carves, instead of starting half the clearance lower (unexplained, from the measured-keycap prototype). Geometry and the fingerprint are unchanged; at a 6 mm clearance thumb_x1's swept overlap goes 9.58 to 14.50 mm³ and thumb_x2's 4.00 to 3.81, now pinne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
2026-10-16 v4: editor cleanup T6: shared Manifold idioms and one memory scope. manifold-util.ts holds prism, slab, place, capsule, meshData, keycapSolid and freeAfter/freeAfterAsync, replacing the copies in she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
2026-10-16 v4: editor cleanup T7: dead code removed. tsconfig checks unused locals and parameters. Gone: the unused Gauss-Newton fit and other ?hand internals and _test entries, wiring's segmentDistance and Obs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
2026-10-16 v4: editor cleanup T8: chassis.ts. The plate sheet moves to plates.ts; buildChassis is pockets, skirts and keycap rooms. Each corner fill is built once (8 hulls where 32 were, 16 of them degenerate 3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
    Geometry unchanged: every check result and solid volume identical; the solid mesh hash changes with the boolean history, but its symmetric difference with the previous solid is under 8e-4 mm³ on every fingerprint variant. The standalone chassis body keeps the 14 x 14 x 3 mm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
2026-10-16 v4: editor cleanup plan: T8 done; the tile pocket depth fix is left for the owner (it newly fails a wire check on the thumbs variant)
2026-10-16 v4: editor cleanup T9: shell.ts dedupe. The carried thumb bin no longer builds the parting, cavity, trough or grill it never used (about 8% faster). The repeated section math (slope, bullnose, flat t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
2026-10-16 v4: editor cleanup T10: shell.ts split into src/shell/: index (shell, c64, thumb angle), bin (breadbin, joined), deck (decks, wells, surfaces), loft (trace, loft, mesh, bezier), sections (profile mat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
2026-10-16 v4: PROTOTYPE ?hand: a fourth preset, No curl: Yours with the thumb's keys within 2.4–3.8 mm of its, reached and pressed without curling: the reach 1.2° of palmar abduction and no curl per degree, th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
2026-10-16 v4: editor cleanup T11: solid.ts. build() calls one function per check, each returning its report part and highlights. seats.ts builds the seats and the switch openings (seatSwitches), and one seatBo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
2026-10-16 v4: editor cleanup T12: wiring.ts split into src/wiring/ (common, tubes, obstacles, port, specs, paths, candidates, negotiate, adapter, index). The strayed/stuck/keep side channels are gone: leg and 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
2026-10-16 v4: PROTOTYPE ?hand: tile check, extra thumb keys, preset refits. Keys whose 19 mm boards (or the socket, LED and diode under them) overlap aren't valid: on No curl and Yours the far and home tiles m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
2026-10-16 v4: PROTOTYPE ?hand: far and near thumb keys parallel to the home key. A thumb setting (a checkbox under the press): the far and near keys face as the home key does and are turned as it is, each wher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
    Co-Aut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
2026-10-16 v4: PROTOTYPE ?hand: thumb keys 20.5 mm apart on Yours and No curl. With the far and near keys parallel to the home key, the keys clear each other down to 20 mm (Yours) and 19.5 mm (No curl), where t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
2026-10-16 v4: editor cleanup T16: main.ts dedupe. Five copies of the edit sequence (validate, snapshot, assign, refresh, mark edited) are one commit(), and undo and redo share step(). Camera, pointer and dispo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
2026-10-16 v4: PROTOTYPE ?hand: far and near thumb keys keep only the home key's y, tilted along the row toward their press. The parallel setting no longer copies the home key's whole facing: each far and near 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
2026-10-16 v4: PROTOTYPE ?hand: extra thumb keys beside the home and far keys, toward the thumb's base. Each is placed, then the thumb fitted to it: seen from above, `south` mm from the key beside it (x1 the ho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
2026-10-16 v4: editor cleanup T17: main.ts split into modules. main.ts is the entry and init sequence only. The other modules: state (the shared state object S), handles (pure handle and field logic), viewer (s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
2026-10-16 v4: editor cleanup T13: ?hand helpers. The six bisections go through hand-solve.ts (halve, bisect, bracketThenBisect), each keeping its own iteration count and step. Duplicated code is shared: rowDis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
2026-10-16 v4: editor cleanup T14: hand-prototype.ts split into src/hand/: model (finger and thumb kinematics, keyAt, thumbRow, extraKeys), layout (settings, presets, solveHand, placement, applyHand), check (ca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
2026-10-16 v4: editor cleanup T15: hand frame. makeFrame runs named stages (setup, joins and webs, keep-out, bar tools, joined sides, legs, truss, rails, tip warnings, thin webs, key faults), each returning its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
2026-10-16 v4: PROTOTYPE ?hand: extra thumb keys placed geometrically, sliders stable. x1 and x2 hang off the thumb row like the next key down a column: from each gap (home/near, far/home) the face carries on s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
2026-10-16 v4: editor cleanup T18: test housekeeping. geometry.test sets up Manifold once and shares solidOf (tests/helpers.ts). The browser specs share project and rebuilt. New hand-case spec: under ?hand the 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
2026-10-16 v4: PROTOTYPE ?hand: extra thumb keys slide along the row. The press slider (it moved nothing, only the checks' press) is replaced by one sliding x1 and x2 together, in mm, along the row from the nea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
2026-10-16 v4: PROTOTYPE ?hand: presets set the extra thumb keys' place. Clicking a preset left x1 and x2's sliders where they were; now it sets them (from the preset, else EXTRA, the place set by eye on Yours)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
2026-10-16 v4: editor cleanup T19: docs and formatting. The editor README is cut to Run, Use, Checks and Validation, with corrected claims: the opening, the thumb keycap, plate margin and skin, what the hardwar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
2026-10-16 v4: PROTOTYPE ?hand: extra thumb keys spaced after they're lowered. Lowered along normals about 11 degrees apart, x1 and x2 closed in again after being spaced (their tiles overlapped 0.3 mm at lower 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
2026-10-16 v4: editor cleanup T20: final comment sweep (comments only, outside src/hand). ?recess is documented as setting both decks' height (Bin.lift), and ?plates lists both values. The bottom section is cal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
2026-10-16 v4: PROTOTYPE ?hand: marks can be painted on the test frame. setupHand returns what marks may land on (the frame, as 'test frame'), and the marks tool adds it to its targets. New browser test paints 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
2026-10-16 v4: marks: clicking a saved mark picks it out in green again
    Clicking a mark in the list goes to its view and draws its strokes green
    (0x39ff3c), with its list entry in green; the other marks stay yellow.
    Clicking another moves it, clicking the same one again drops it, and
    ?mark=<id> opens with that mark picked. This came from bb50a20, which was
    committed on worktree-breadbin-box and never merged into main or this
    branch, so the editor cleanup never had it. Restored without the
    variant/thumbs filtering that T7 removed. getMarks() test hook and a
    new marks.spec.ts (run by the dev-server config, npm run test:hand) pin it.
2026-10-16 v4: PROTOTYPE ?hand: frame bars meet the plates inside their corners, and nothing stands above them. The struts were centred on a plate's corner edge, so each stuck up past the plate top (up to 1.4 m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
2026-10-17 v4: PROTOTYPE ?hand: frame rails run round the outline and between the thumb's and fingers' keys, and every foot stands on one. A plate's rail ring went round its feet in order of angle from their mi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
2026-10-17 v4: PROTOTYPE ?hand: the thumb row turns as one toward the thumb's base (new Swung in preset), the 1.5u home key sits in line with the far and near keys, and the height always shows. New thumb settin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
2026-10-17 v4: PROTOTYPE ?hand: Swung in's extra keys sit 1 mm higher (lower -1, was 5), bringing the board to 58.6 mm tall.
2026-10-17 v4: the Skeletyl frame (back from 5e13c33 as src/skeletyl.ts) is the default chassis again (chassis.style "skeletyl"; "c64" or ?chassis=c64 builds the C64 case), and the ?hand starts on Swung in. The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
2026-10-17 v4: the Skeletyl frame is rebuilt from scratch as meshed ribs on a rail (skeletyl.ts 1236 lines to 348). A rib runs along each finger column and each thumb row: one watertight mesh swept through stat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
2026-10-18 v4: the Skeletyl's perimeter is rounded and stands out from the outer sides, neighbouring columns' drops are banded together, and a parted end gets a round where it has room. The outline is the dug h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
2026-10-18 v4: PROTOTYPE Skeletyl walls, switchable: a bar at the bottom of the editor (dev only; arrows or the ←/→ keys) sets ?walls= (cfg.chassis.walls) and rebuilds: none, flare (a skirt sweeping out to the 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
2026-10-18 v4: the editor's height reads the keycaps' tops precisely: a tilted keycap's own box, turned upright, stood higher than its corners (Swung in read 64.5 mm; it is 62.6).
2026-10-18 v4: PROTOTYPE Skeletyl rib-end supports, switchable: a second bar above the walls bar (dev only; arrows or the ↑/↓ keys) sets ?ends= (cfg.chassis.ends) and rebuilds: none, beam (a cross beam under th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
2026-10-18 v4: PROTOTYPE ?ends=legs: each hanging end stands on its own leg, a cabriole S from the round's bottom to the rail, twisting from a flat bar to a foot standing across the rail. Legs are picked from r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
2026-10-18 v4: PROTOTYPE ?ends=braces: each hanging end gets one straight brace (4×3 mm, about 45°, a gusset under the end) to the nearest solid thing clear of the keys: the rail, a dropped end, a thumb plate's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
2026-10-18 v4: PROTOTYPE ?ends=arch: the hanging ends are carried on upright webs (2.3 mm) whose top edge runs under the ends and whose underside is a multifoil arch: a lobe under each finger front, cusps betwe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
2026-10-18 v4: Swung in is the default layout, so the tests build it (src/default-config.json is the ?hand preset applied to the old defaults). A new test pins Swung in's known Skeletyl failures (its extra thum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
2026-10-18 v4: PROTOTYPE Skeletyl rib-end supports, round 2, built from the frame's own parts: ?ends=tie (a floor tie of the rail's own section across the floor under the hanging ends, rail to rail, filleted in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
2026-10-18 v4: drop the hand-side LED capacitors. The per-column ceramic open point is closed: no capacitors on the hands, bulk or per column; the pod keeps the 100 nF across its level shifter.
2026-10-18 v4: PROTOTYPE Skeletyl ?ends=flow and bendable rib paths. A rib's path is now a sweep of poses (each side's top on its own cubic, handles at circular-arc length), so a rib can bend along its length; 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
2026-10-18 v4: the tile pocket no longer counts the board twice. A tile part's center_mm[2] is from the board's top, but the pocket depth and the ?hand check's tile boxes added it to the underside, 1.6 mm too d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
2026-10-18 v4: the measured key tile in the editor. 17 × 17 × 1.6 mm with 1.5 mm corner notches (corner_notch_radius_mm); socket, LED (with its leads) and diode 1.9, 1.1 and 0.8 mm under the board at their meas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
    One wire per hole: an undir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
2026-10-18 v4: record the measured key tile. Design status gains the tile (17 mm, 1.5 mm notches, part heights, pocket 8.8 mm), its holes and pads and what the meter joins, one wire per hole (22 AWG fits, two d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
2026-10-18 v4: PROTOTYPE Skeletyl drops are the ribs bending onto the base. A dropping end is one sweep from its round to the floor: straight down where the rail is under it, otherwise bending out along the end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
2026-10-18 v4: the Skeletyl keeps every key's opening column clear. With the measured tile's smaller pockets and no flare, the rail ran through thumb_far's switch-hole column (it sits low and tilted, so the col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
2026-10-18 v4: PROTOTYPE Skeletyl drops and webs keep the rib's own section. sweepAt's normal (the slerp between the two poses' normals) was not divided by sin of their angle, and since 3accb9c the interior pos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
2026-10-18 v4: wires keep clear of the base plate. The router drops any route whose underside runs below chassis.skin_mm above z = 0 (Env.floorZ; a wire's centreline at least skin + diameter/2), alongside the r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
2026-10-18 v4: the ?hand height readout measures from the tile pocket. heightOf took the lowest switch body's bottom (5 mm under the plate top); the lowest thing under a key is its tile pocket, tilePocketDepth 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
2026-10-18 v4: Swung in's comment gives the board's height as ?hand now reads it, to the tile pocket (62.9 mm).
2026-10-19 v4: Swung in is the only key layout. Removed the ?hand presets Dactyl fit, Natural, Yours and No curl, the EXTRA default and the "Start from" buttons; the layout before Swung in that tests switched t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
    Tests moved onto Swung in, with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
2026-10-19 v4: PROTOTYPE Skeletyl ribs are one mesh, ends and all. On Swung in (mark 20261019-151559-chassis, ?ends=none, and ?ends=flow) every back drop showed a hairline across where its round meets the drop,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
    Each ri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
2026-10-19 v4: PROTOTYPE the Skeletyl's ?ends= variants join and both go. flow does what they did (each column front still hanging joined to a thumb plate, joinTo, then the tie for the rest) and carries the thu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
2026-10-19 v4: PROTOTYPE ?walls=bones limbs flare into the rib and the rail, and the thumb strut moves to the flow web into the ring column. Each limb's ends were capped: a round tube ran straight into the rib'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
2026-10-19 v4: PROTOTYPE ?walls=bones Ys are real forks, and every limb is one smooth bend chosen clear rather than pushed round keys. The second branch of each Y was its own tube started shrunk inside the firs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
2026-10-19 v4: PROTOTYPE every Skeletyl drop's outer face is flush with the rail over the rail's whole height, whatever the drop's height. The foot rule was min(railHeight, half the drop's top), which failed fo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
2026-10-19 v4: PROTOTYPE seam check for the Skeletyl. tests/seams.ts finds where the frame's parts meet badly on the mesh as the editor draws it (creased normals at 30°, unweighted): slivers, ledges and steps u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
2026-10-19 v4: PROTOTYPE ?walls=wishbone and ?walls=pillars: Skeletyl walls built as the ribs are, the rib carried on sideways out of each key plate's outer edge and turned down to the rail, in answer to bones 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
2026-10-19 v4: PROTOTYPE the Skeletyl's bands go, and small bridges tie neighbouring ribs together up at the plates. The bands (the walls filling between neighbouring columns' back drops) are gone: band(), band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
2026-10-19 v4: PROTOTYPE fused drops: two Skeletyl drops of different ribs whose facing sides stand within fuseGap (1.5 mm) of each other, too narrow a slit to print cleanly, are widened into each other, so the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
2026-10-19 v4: Swung in's extra thumb keys are in the default: SWUNG_IN has extra.on true, so the hand panel starts with them and Reset model (the default project) has them where the hand puts them, beside the 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
2026-10-19 v4: PROTOTYPE no coincident contact at the Skeletyl's feet, and drops on the tie stand wholly on it. With Swung in's extra keys in the default, 12 seam tests failed: zero-volume second pieces on none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
    Specks: a drop's foot stood on the rail face to face, its edges on the rail's top, and railDip's dipMesh points fell a hair off the foot's edges, so the union left slivers of no volume there (on flow at the extra keys' front foot; on flare, the skirt also lay on a hanging round's face at the thumb row's back). By rule n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
2026-10-19 v4: PROTOTYPE the Skeletyl's outline runs straight from foot to foot, and low ends' rounds are as tight as clear. The outline is the convex hull of the feet, the outer sides and what the rail keeps c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
2026-10-19 v4: PROTOTYPE the Skeletyl's rib limbs (?walls=pillars and wishbone) leave their rib at the web between two keys, fork at one fixed slant, fork over the ribbon, and stand flush on the straightened ou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
    Placement, by rule for every outer side: a limb leaves at the middle of each web between neighbouring keys, as wide as the web allows with its sides 0.5 mm in from the plates' corners (6 mm for a pillar, 8 mm for a trunk, or narrower; a web with no room for 4 mm gets none). It turns down in one round and runs straight do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
2026-10-19 v4: PROTOTYPE the Skeletyl's drops never twist: each stands straight down, or bends out only in its end's own plane, and the outline turns in crisply to its face instead. Before, a drop under a strai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
    Rule: a drop keeps its across and width as at the bottom of its round all the way down to a square foot, as a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
2026-10-19 v4: glue posts replace the glue pads: each tile is held under its plate, on the Skeletyl and the C64, by a round post in each corner notch (radius 1.35, concentric, 0.15 clear) and, along the two edg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
2026-10-19 v4: PROTOTYPE every Skeletyl rib limb (?walls=pillars and wishbone) is one width, S.width 3.4 mm, from its root to its feet: pillar, wishbone trunk and legs alike, in answer to mark 20261020-095551-c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
2026-10-20 v4: PROTOTYPE the Skeletyl's rail is level everywhere (railHeight) and never dips; a low end (isLow: its round, as tight as clears, still ends less than dropBend over the rail's top) has no drop of i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
2026-10-20 v4: PROTOTYPE the glue posts' corner posts are whole rounds that fill the tile's corner notches, in answer to mark 20261020-121221-chassis ("doesn't look anything like what I asked for"): the notches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
2026-10-20 v4: PROTOTYPE the Skeletyl's rib limbs (?walls=wishbone and pillars) turn down at once and stand near under their columns, in answer to mark 20261020-125426-chassis ("the joints from the top of the w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
2026-10-20 v4: PROTOTYPE a Skeletyl rib limb (?walls=wishbone and pillars) supports each web a rib's end carries on in (?ends=flow), in answer to "could you add a wall strut to support the thumb extra column ro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
2026-10-20 v4: PROTOTYPE every Skeletyl bridge between neighbouring ribs is a straight slab, however wide the gap, in answer to mark 20261020-130032-chassis ("the bridges between columns are missing when the ga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
2026-10-20 v4: PROTOTYPE every Skeletyl rib end that rises off its plate leaves it level and turns down in the tightest round, so no end stands higher than its plate's edge, in answer to mark 20261020-125322-ch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
2026-10-20 v4: PROTOTYPE each Skeletyl rib's high end is levelled across (left to right) over its round, in answer to mark 20261020-125322-chassis ("lower the "ears" at the high end of all the ribs ... to rough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
2026-10-20 v4: drop the Cirque trackpad from the docs; v4 has no pointing device
    The README's "pointing device is open" line is gone, and design-status no longer lists the pointing device as open or a Cirque overlay as decided. The trackball notes in chassis-foundation and the key PCB quote options now say it is left from an earlier plan. design-status's ATmega32U4 note is updated for the RX change: the hands' rows join into a 4 x 10 matrix (14 pins), not C0-C5 into 6 x 6.
2026-10-20 Split out of rosebear: v4/ moves to the root, output_v4/ becomes output/
    This repo was rosebear's v4/. Paths, the repo-root depth in the tools and tests, and the docs follow the move; make targets drop the v4 prefix (make build, test, editor, chassis...). v3/ holds the rosebear v3 sources the seeded pipeline still builds from; v3/README.md says what they are and what depends on them.
2026-10-20 Replace v3/ with seed/: only the rosebear v3 sources the seed reaches
    seed/ is the BAML project seed_export runs (tools/seed.baml moves in beside it), pruned to the 378 definitions reachable from seed_export and the functions seed.py patches; v3's tests, its own build entries, the thumb and thumb-routing files and 280-odd other definitions go. header_for moves from pod_test.baml into pod.baml, merge_boards from panel.baml into emit.baml. Only the 1u hotswap footprint was ever placed: it moves to footprints/rosebear.pretty, and the other sizes and their generator go. The seed's own fp-lib-table now points at the repo's footprints. geometry.json and the seed boards rebuild byte-identical; the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
    [pod_pins.py, seed.py]
2026-10-20 PROTOTYPE revert e113ed5 (level ears across): in answer to mark 20261020-192101-chassis, the levelled high ends warped the rounds into twisted curves. Each rib's high end is back on its plate's roll 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
2026-10-20 PROTOTYPE Pro Micro variant (?controller=pro_micro): an nRF52840 board in Pro Micro form factor and a TRRS jack in each hand in place of the FFC adapter, ribbon and pod. Each net's feeds land on its 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
2026-10-20 Pro Micro variant doc: parts, pins, the TRRS link, LED power and open questions
